jfkure/shot-timer-mk1/hardware/enclosure/Shot_Timer_Mk1_Enclosure_Drawings.pdf

# Shot Timer Mk1

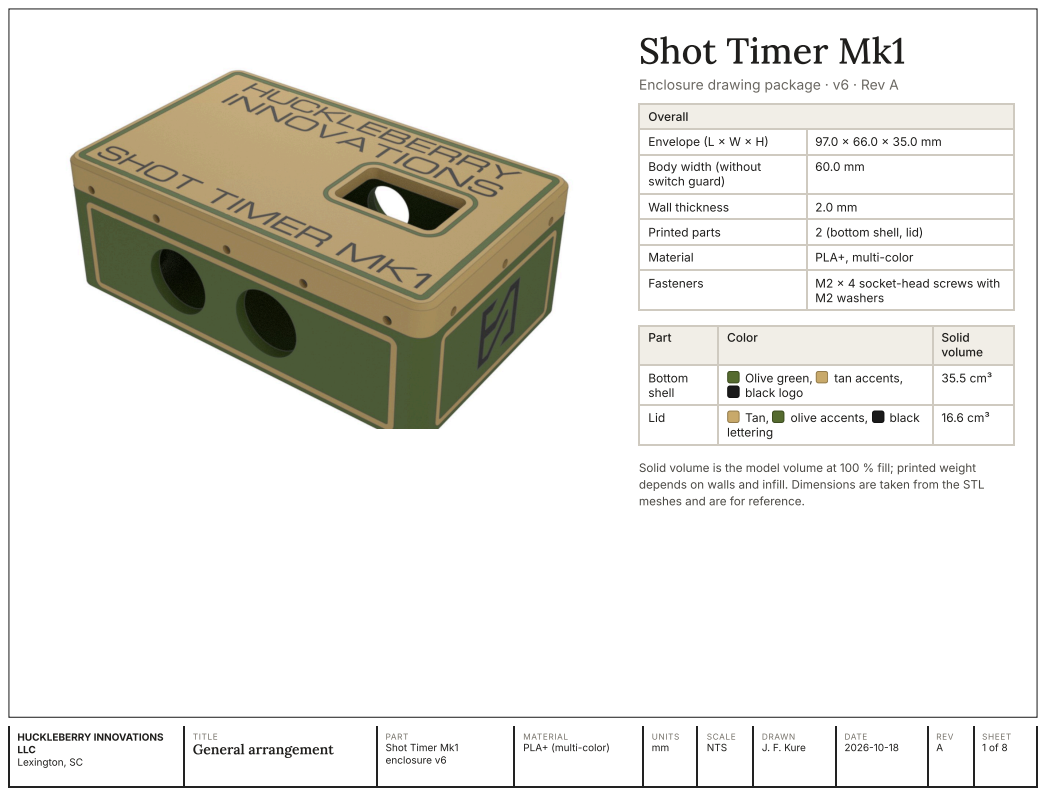
[picture p1: page 1]
Overall; HUCKLEBERRY INNOVATIONS LLC Lexington, SC; TITLE; General arrangement; PART Shot Timer Mk1 enclosure v6; UNITS mm; SCALE NTS; DRAWN J. F. Kure; DATE 2026-10-18; REV A; SHEET 1 of 8

Enclosure drawing package · v6 · Rev A

Envelope (L × W × H) | 97.0 × 66.0 × 35.0 mm
Body width (without switch guard) | 60.0 mm

Wall thickness | 2.0 mm
Printed parts | 2 (bottom shell, lid)
Material | PLA+, multi-color

Fasteners | M2 × 4 socket-head screws with M2 washers

Part | Color | Solid volume

Bottom shell | Olive green, tan accents, black logo | 35.5 cm³

Lid | Tan, olive accents, black lettering | 16.6 cm³

Solid volume is the model volume at 100 % fill; printed weight
depends on walls and infill. Dimensions are taken from the STL
meshes and are for reference.

MATERIAL
PLA+ (multi-color)

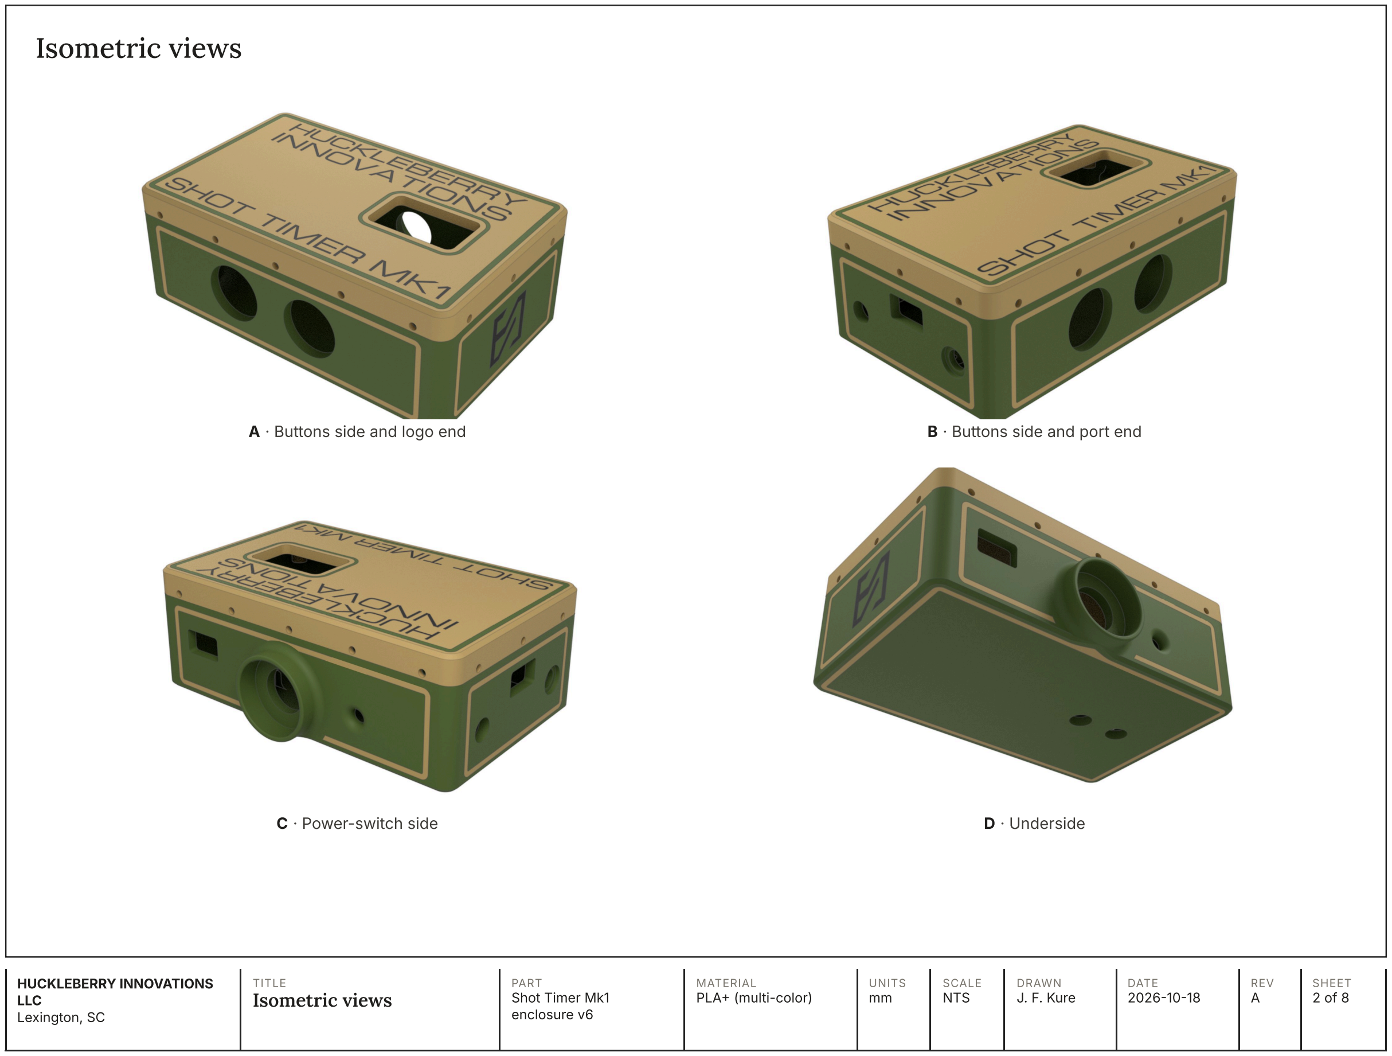
[picture p2: page 2]

### Isometric views

HUCKLEBERRY INNOVATIONS
LLC

TITLE
Isometric views

PART
Shot Timer Mk1

MATERIAL
PLA+ (multi-color)

UNITS
mm

SCALE
NTS

DRAWN
J. F. Kure

DATE
2026-10-18

REV
A

SHEET
2 of 8
A · Buttons side and logo end | B · Buttons side and port end
C · Power-switch side | D · Underside

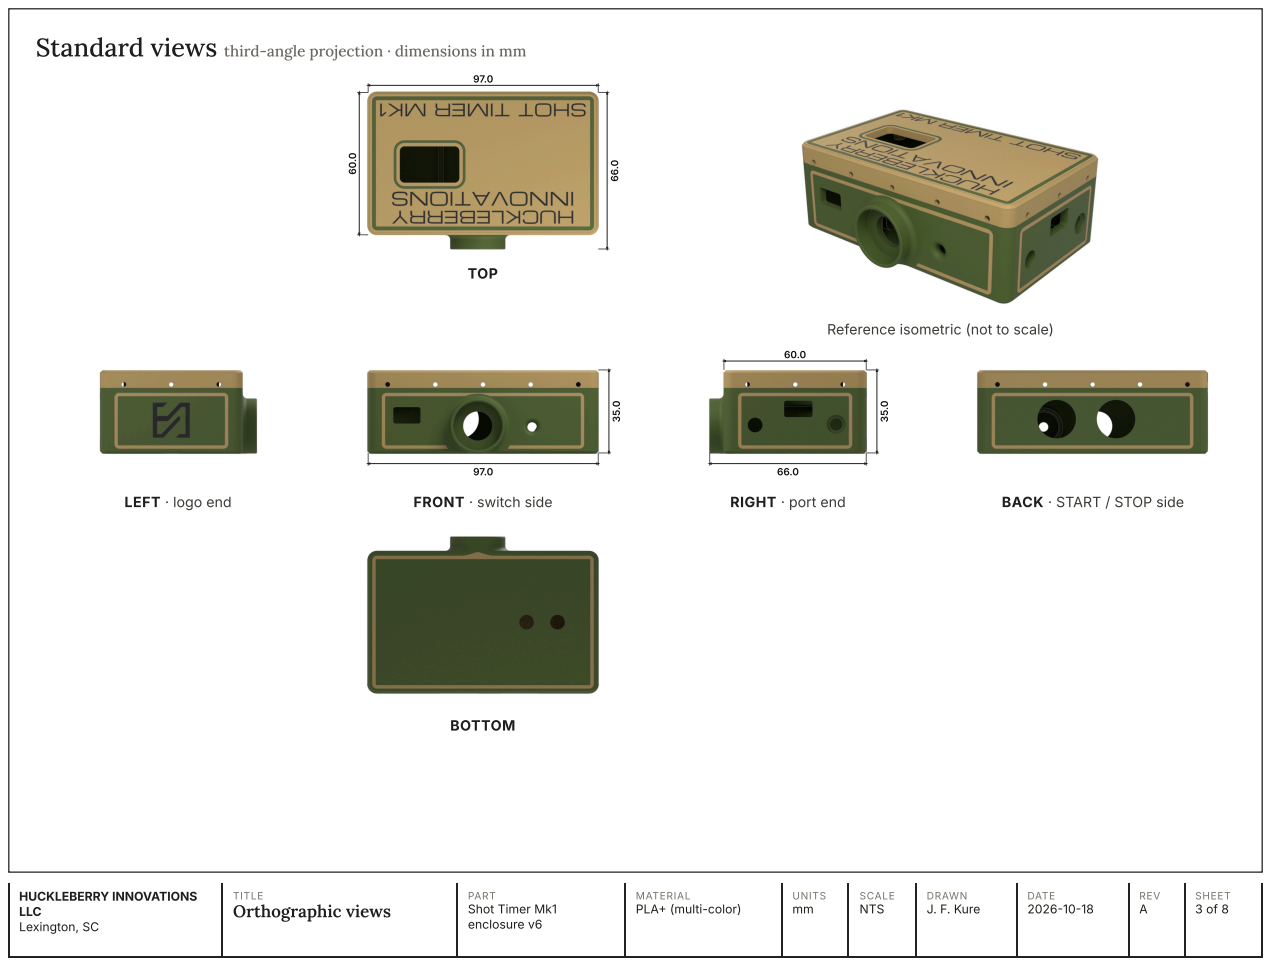
[picture p3: page 3]
HUCKLEBERRY INNOVATIONS LLC; TITLE Orthographic views; PART Shot Timer Mk1; UNITS mm; SCALE NTS; DRAWN J. F. Kure; DATE 2026-10-18; REV A; SHEET 3 of 8; TOP; LEFT · logo end; FRONT · switch side; RIGHT · port end; BACK · START / STOP side; BOTTOM

Standard views third-angle projection · dimensions in mm

Reference isometric (not to scale)

MATERIAL
PLA+ (multi-color)

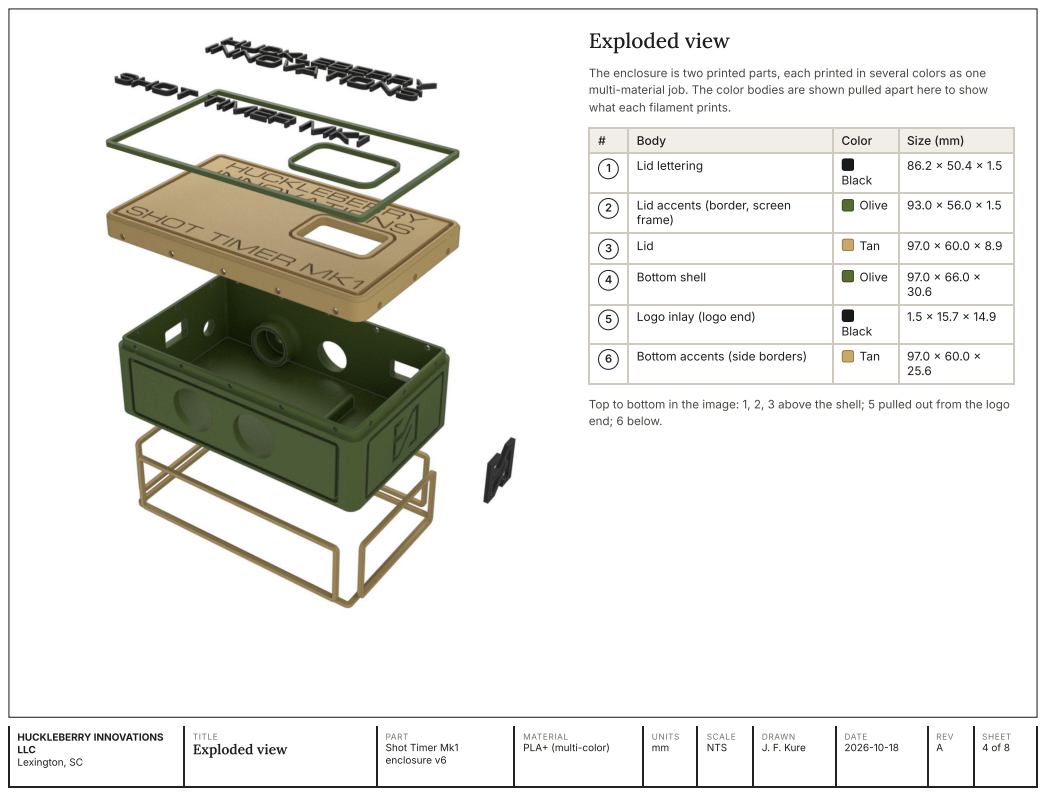
[picture p4: page 4]
Exploded view; HUCKLEBERRY INNOVATIONS LLC; TITLE Exploded view; PART Shot Timer Mk1; UNITS mm; SCALE NTS; DRAWN J. F. Kure; DATE 2026-10-18; REV A; SHEET 4 of 8

The enclosure is two printed parts, each printed in several colors as one
multi-material job. The color bodies are shown pulled apart here to show
what each filament prints.

# | Body | Color | Size (mm)
1 | Lid lettering | Black | 86.2 × 50.4 × 1.5

2 | Lid accents (border, screen frame) | Olive | 93.0 × 56.0 × 1.5

3 | Lid | Tan | 97.0 × 60.0 × 8.9

4 | Bottom shell | Olive | 97.0 × 66.0 × 30.6

5 | Logo inlay (logo end) | Black | 1.5 × 15.7 × 14.9

6 | Bottom accents (side borders) | Tan | 97.0 × 60.0 × 25.6

Top to bottom in the image: 1, 2, 3 above the shell; 5 pulled out from the logo
end; 6 below.

MATERIAL
PLA+ (multi-color)

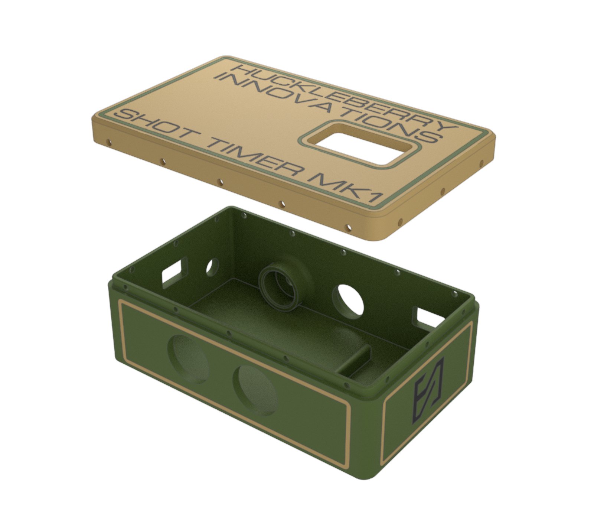
[picture p5: figure]

### Lid to shell

The lid sits on the shell with a lip that overlaps the shell walls by about 4.5 mm (lid underside at 26.1 mm, shell rim at 30.6 mm). It is held by M2 × 4 socket-head screws and M2 washers through the holes around the rim: five along each long side and three at each end, sixteen in all.

Item | Qty | Notes
Bottom shell | 1 | Electronics, buttons, switch and battery mount here
Lid | 1 | OLED shows through the screen window
M2 × 4 socket-head screw | 16 | Lid screws (rim holes)
M2 flat washer | 16 | Under each lid screw

HUCKLEBERRY INNOVATIONS LLC; TITLE Lid assembly; PART Shot Timer Mk1; MATERIAL PLA+ (multi-color); UNITS mm; SCALE NTS; DRAWN J. F. Kure; DATE 2026-10-18; REV A; SHEET 5 of 8

### Part · Bottom shell

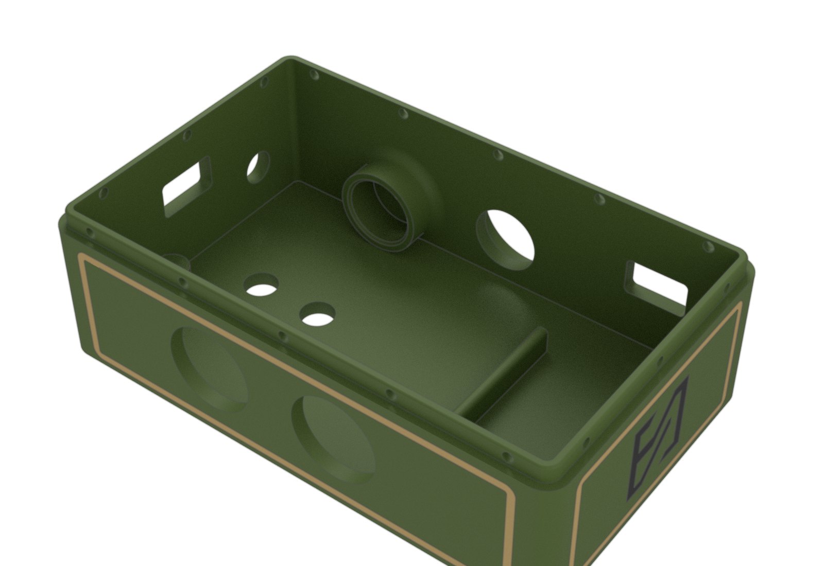
[picture p6: figure]
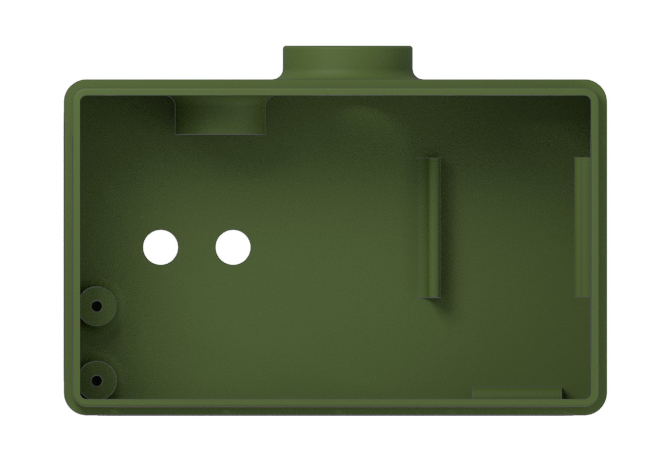
[picture p7: figure]

Feature | Size (mm) | Location
START / STOP button holes (2) | Ø 16.3 | Back wall, for 16 mm buttons
Power switch hole | Ø 12.3 | Front wall, inside the raised switch guard
Front wall openings | 7.0 × 11.5 slot; Ø 4.5 hole | Front wall, either side of the switch
Port-end openings | 7.0 × 12.0 slot; Ø 8.0 and Ø 6.3 holes | Right end wall
Floor holes (2) | Ø 6.4 | Floor
Inside cavity | 93.0 × 56.0, 2.0 walls | Shell height 30.6
Isometric | Top view into the cavity

HUCKLEBERRY INNOVATIONS LLC; TITLE; Bottom shell; PART Shot Timer Mk1; MATERIAL PLA+ (multi-color); UNITS mm; SCALE NTS; DRAWN J. F. Kure; DATE 2026-10-18; REV A; SHEET 6 of 8

Part · Lid

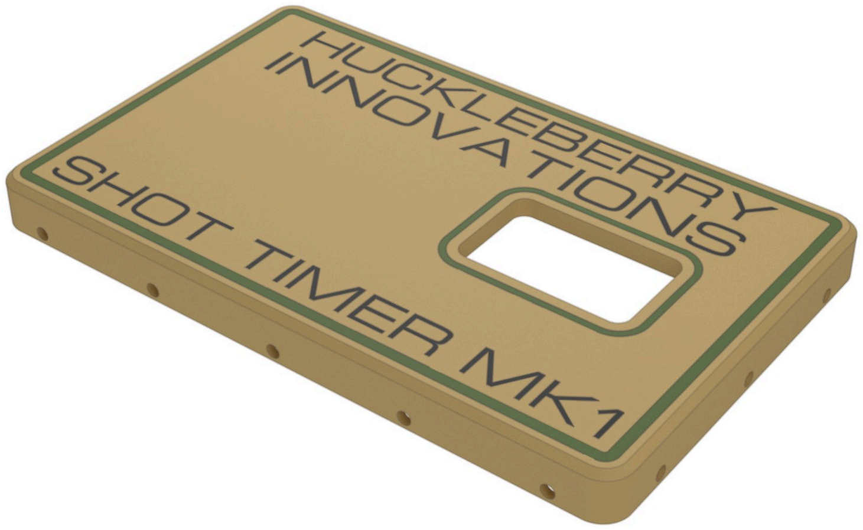
[picture p8: figure]
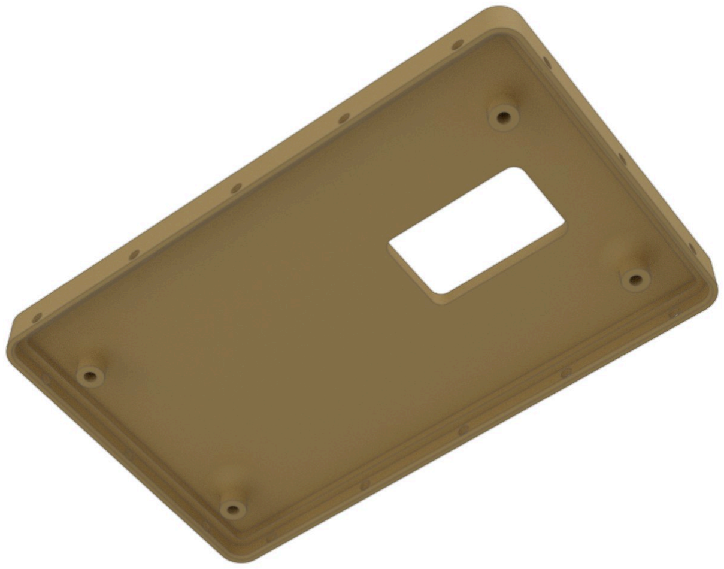
[picture p9: figure]

Feature | Size (mm) | Notes
Lid outline | 97.0 × 60.0 × 8.9 | Top face at 35.0 mm when assembled
Screen window | 25.0 × 15.2 opening, 30.0 × 20.2 frame | For the 0.96 in OLED
Lettering and border inlays | 1.5 deep | "HUCKLEBERRY INNOVATIONS", "SHOT TIMER MK1"
Isometric | Underside

HUCKLEBERRY INNOVATIONS LLC; TITLE Lid; PART Shot Timer Mk1; MATERIAL PLA+ (multi-color); UNITS mm; SCALE NTS; DRAWN J. F. Kure; DATE 2026-10-18; REV A; SHEET 7 of 8

### Color bodies

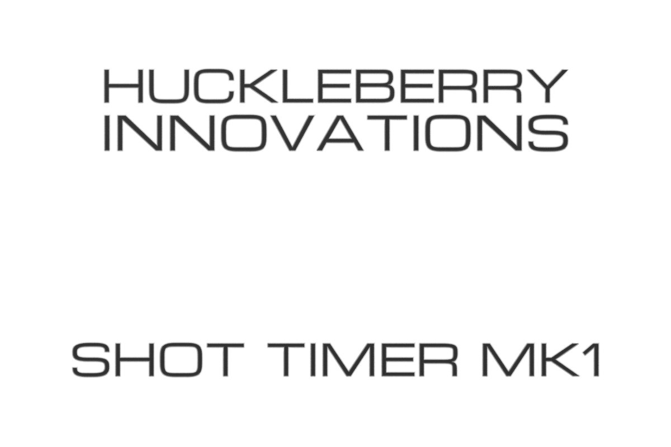
[picture p10: figure]

Files

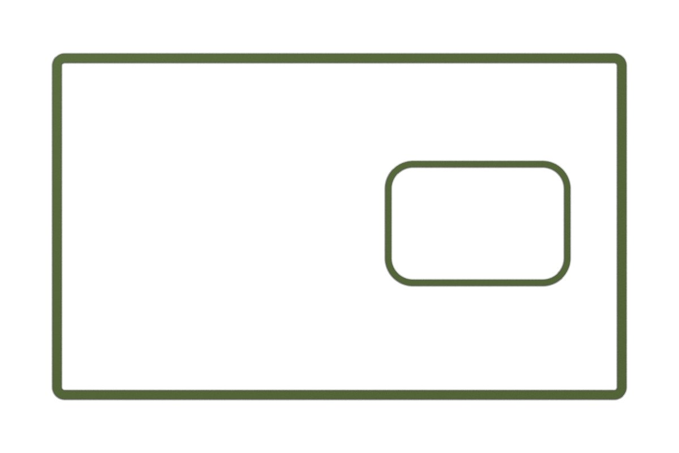
[picture p11: figure]
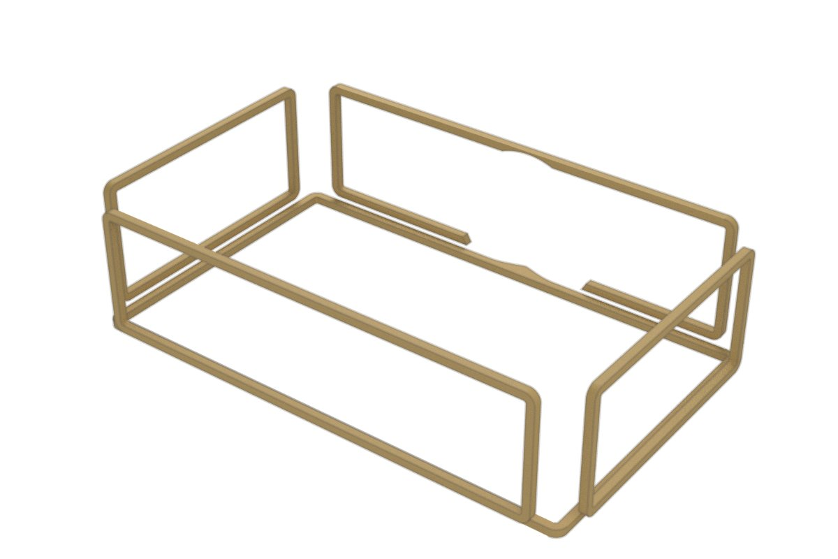
[picture p12: figure]
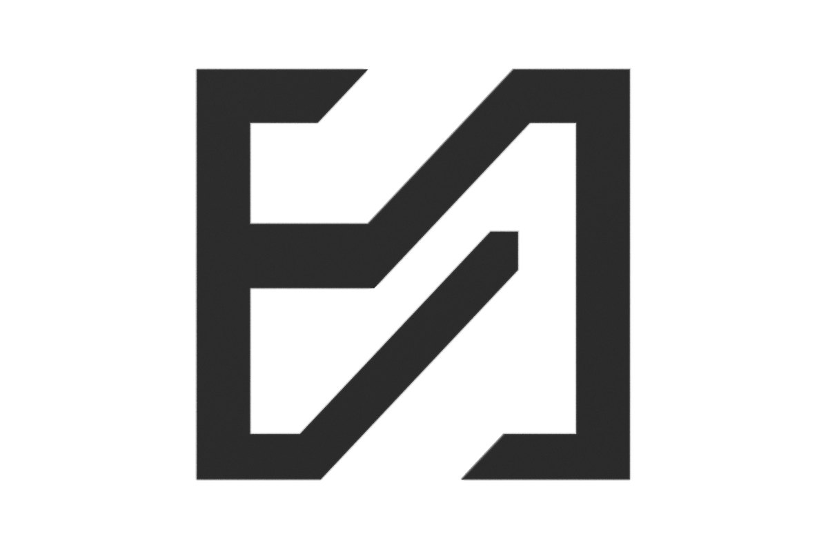
[picture p13: figure]

File | Body | Triangles
shot-timer-mk1 -shot timer enclosure v6 bottom olive green.stl | Bottom shell | 108,440
shot-timer-mk1 -Composite part bottom accents tan.stl | Shell accents | 6,192
shot-timer-mk1 -Composite part bottom logo black.stl | Logo | 88
shot-timer-mk1 -shot timer enclosure v6 top tan.stl | Lid | 77,008
shot-timer-mk1 -Composite part top accents olive green.stl | Lid accents | 2,376
shot-timer-mk1 -Composite part top names black.stl | Lid lettering | 15,436
shot-timer-mk1-bottom.3mf, shot-timer-mk1-top.3mf | Multi-color print projects with colors assigned | —

All STL files share one coordinate system, so loading them together in a slicer puts every color body in place. Print settings (layer height, infill, supports, orientation) are not recorded here yet.

Lid lettering · black | Lid accents · olive | Shell accents · tan

Logo · black

HUCKLEBERRY INNOVATIONS LLC; TITLE Color bodies and files; PART Shot Timer Mk1; MATERIAL PLA+ (multi-color); UNITS mm; SCALE NTS; DRAWN J. F. Kure; DATE 2026-10-18; REV A; SHEET 8 of 8
