jfkure/shot-timer-mk1/docs/Shot_Timer_MK1_Quick_Start_Fold_v1.7.5_BW.pdf

## SPECIFICATIONS

MCU | Arduino Nano
DISPLAY | 0.96" Dual-Color OLED
AUDIO | 3.5mm jack, clip-on lavalier
POWER | 9V USB-C Rechargeable Lithium
BATTERY GAUGE | % on every screen, ~16 hr runtime
POWER BTN | Latching, Blue-Lit, Guarded
MEMORY | 60 Shots / last string saved
RESOLUTION | 0.01 s display, 0.10 s min split
START DELAY | Random, 3–8 s
ENCLOSURE | PLA+ 3D Printed
FIRMWARE | Open Source v1.7.5
SOURCE | github.com/jfkure/shot-timer-mk1
LICENSE | GPL-3.0 · CERN-OHL-S · CC BY-SA
PRICE | $75.00 USD

### ORDER: order@huckleberryinnovations.com

HUCKLEBERRY INNOVATIONS — LEXINGTON, SC

# SHOT TIMER

MK1

HUCKLEBERRY INNOVATIONS
OPERATOR QUICK-START
HI

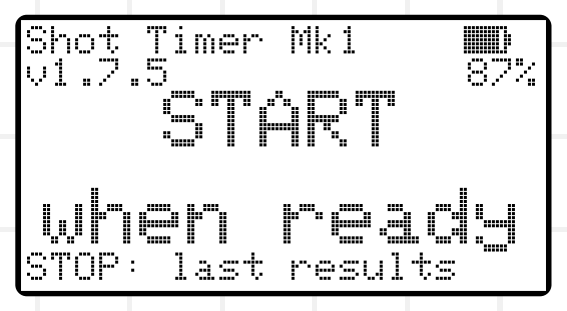
[picture p14: figure]

START SCREEN · v1.7.5

LEXINGTON, SC
J.F. KURE
v1.7.5

### 00 // POWER

A | POWER | Glows blue — timer ON, battery % top right
B | POWER | Depress — timer OFF, no battery drain

* Recessed guard prevents accidental presses

### 01 // RUN A STRING

1 | TAP START | LED on — random 3–8 s wait
2 | BUZZER · GO! | LED blinks — shoot, shots timed
3 | PRESS STOP | LED off — string saved, results up

Keep START a quick tap; holding 2 s opens test mode. Up to 60 shots. A pause over 65.5 s shows as 65.53+.

### 02 // REVIEW RESULTS

1ST SHOT › AVERAGE › SPLITS › TOTALS › BATTERY Tap STOP to step through pages; times in seconds. At power-on, tap STOP for your last string.

1ST SHOT · draw time | SPLITS · 3 per page

### 03 // BATTERY

Charge until the battery light turns green, then mark it full:
1 | TAP STOP | Go to the BATTERY page
2 | HOLD START 3s | MARK FULL? appears
3 | TAP STOP | FULL — gauge set to 100%
LOW | 15% left (~2 hr) — beep every 60 s
CHARGE | 5% left (~45 min) — double beep every 30 s

Rechargeable 9V lithium only. No beeps while shooting.

### 04 // SETUP

A | HOLD STOP 2s | Sensitivity: START +10, STOP saves
B | HOLD START 2s | Test mode: live mic level, STOP exits
C | HOLD BOTH 3s | Factory reset (threshold back to 150)

TIP Threshold 150 suits most ranges. Extra shots counted? Raise it. Shots missed? Lower it.

WHITE LED
- SOLID | Waiting for the beep · test & setup screens
~ BLINK | Clock running, listening for shots
- OFF | String stopped · reviewing results
START | STOP | POWER (lit when on)

huckleberryinnovations.com // github.com/jfkure/shot-timer-mk1 // LEXINGTON, SC

## SHOT TIMER MK1 — OPERATOR REFERENCE
