jfkure/shot-timer-mk1/docs/Shot_Timer_MK1_Parts_Inventory.pdf

Shot Timer MK1 Parts Inventory | Huckleberry Innovations LLC | BOM firmware v1.7.5, enclosure v6
Date: | Counted by: | Units to build:
Ref | Part | Per
timer

Pack
qty

On

hand | Need | Short | Order
(packs)

Ordered
/ date | Notes
U1 | Arduino Nano (ATmega328P) USB-C | 1 | 3
U2 | 0.96in SSD1306 OLED 128x64 I2C | 1 | 1
U3 | INA219 current sensor (0.1 ohm shunt) | 1 | 3
PCB1 | ElectroCookie solderable protoboard | 1 | 5
MK1 | Clip-on lavalier microphone 3.5mm TRRS | 1 | 1
J1 | TRRS 3.5mm breakout board | 1 | 6
BT1 | 9V USB-C rechargeable lithium battery | 1 | 5
BT1-CLIP | 9V battery clip with leads | 1 | 10
SW1 | Latching power switch blue-lit guarded | 1 | 6
SW2 | 16mm push button green (START) | 1 | 5
SW3 | 16mm push button red (STOP) | 1 | 5
LS1 | Buzzer | 1 | 5
D1 | White LED panel-mount | 1 | 5
CONN | 2-pin wire connector/plug | 3 | 30
R1 | 10k 1% resistor | 1 | 25
R2a/R5 | 2.2k 1% resistor | 2 | 25
R2b | 4.7k 1% resistor | 1 | 25
R3 | 100k 1% resistor | 1 | 25
R4a | 22k 1% resistor | 1 | 25
R4b | 68k 1% resistor | 1 | 25
C1 | 10uF electrolytic capacitor | 1 | 10
ENC | 3D-printed PLA+ enclosure (top + bottom) | 1 | 1
HW1 | M2x4 socket head screw | 22 | 100
HW2 | M2 flat washer | 22 | 500
CLIP | Belt clip | 1 | 2

Hookup wire

Solder

Heat shrink

PLA+ filament

Notes / reorder list | Need = Per timer x units to build. Short = Need - On hand.
Rows from hardware/BOM.csv (github.com/jfkure/shot-timer-mk1). Hardware CERN-OHL-S-2.0, docs CC BY-SA 4.0. | CONN comes in pairs. Battery: 9V USB-C rechargeable lithium only.
