jfkure/shot-timer-mk1/hardware/enclosure/port-plug-measured.stl

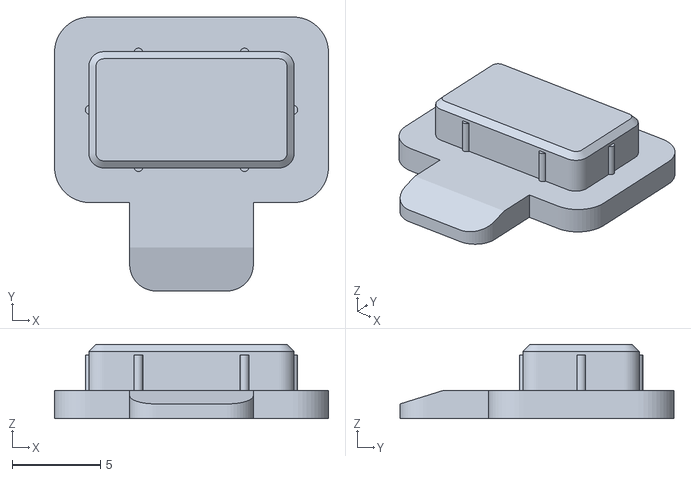
[picture p15: CAD file, 2026-10-19]
hardware/enclosure/port-plug-measured.stl
15.5 x 15.5 x 4.20
