jfkure/shot-timer-mk1/hardware/enclosure/shot-timer-mk1 - Composite part top accents olive green.stl

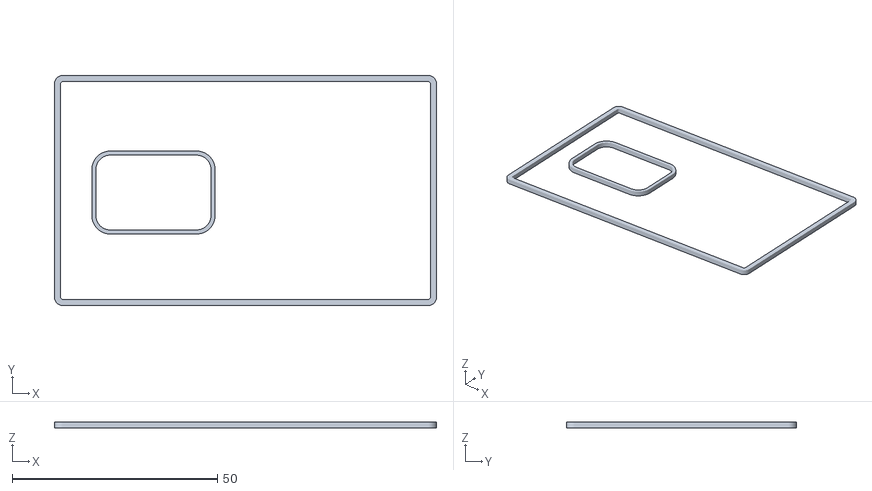
[picture p16: CAD file, 2026-10-19]
hardware/enclosure/shot-timer-mk1 - Composite part top accents olive green.stl
93.0 x 56.0 x 1.50
