jfkure/shot-timer-mk1/hardware/enclosure/shot-timer-mk1-bottom.3mf

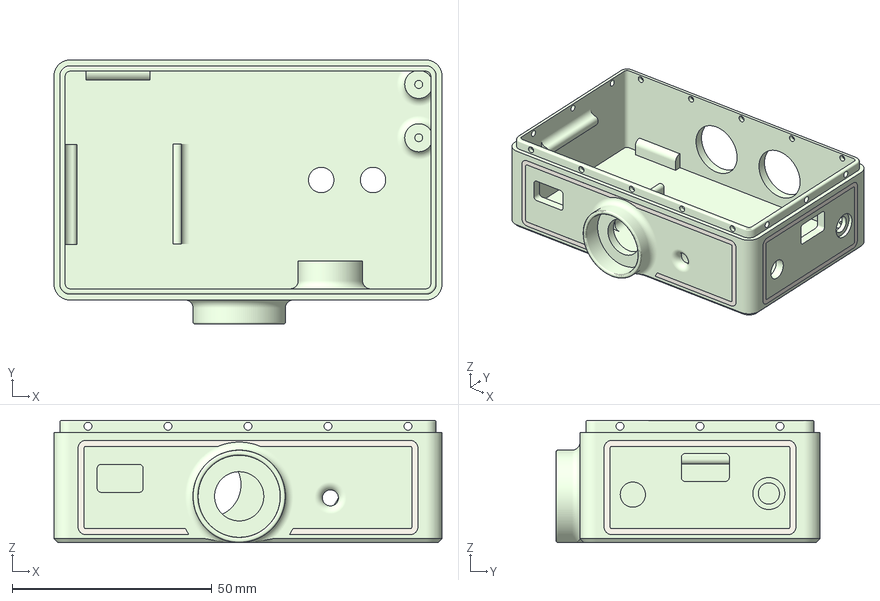
[picture p17: CAD file, 2026-10-19]
hardware/enclosure/shot-timer-mk1-bottom.3mf
97.0 x 66.0 x 30.6 mm
shot timer enclosure v6 bottom olive green
bottom-start-stop-buttons-accent
bottom-logo-border-accent
bottom-enclosure-accent
bottom-headphone-jack-accent
bottom-logo-accent
bottom-power-switch-accent
