jfkure/shot-timer-mk1/hardware/enclosure/shot-timer-mk1 - shot timer enclosure v6 bottom olive green.stl

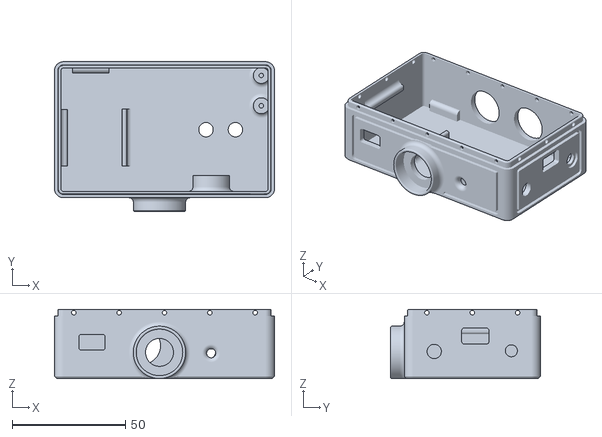
[picture p18: CAD file, 2026-10-19]
hardware/enclosure/shot-timer-mk1 - shot timer enclosure v6 bottom olive green.stl
97.0 x 66.0 x 30.6
