jfkure/shot-timer-mk1/hardware/enclosure/shot-timer-mk1-top.3mf

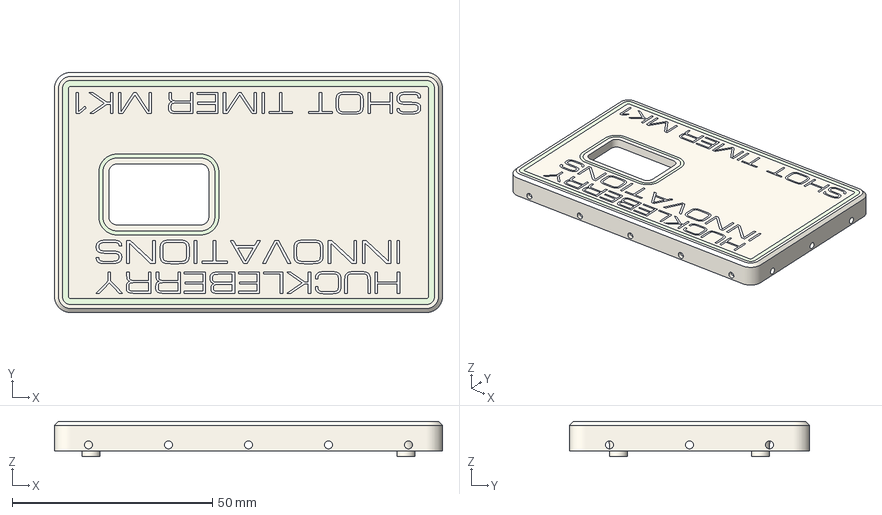
[picture p19: CAD file, 2026-10-19]
hardware/enclosure/shot-timer-mk1-top.3mf
97.0 x 60.0 x 8.87 mm
top-enclosure-accent
top-screen-accent
shot timer enclosure v6 top tan
