jfkure/shot-timer-mk1/hardware/enclosure/shot-timer-mk1 - Composite part top names black.stl

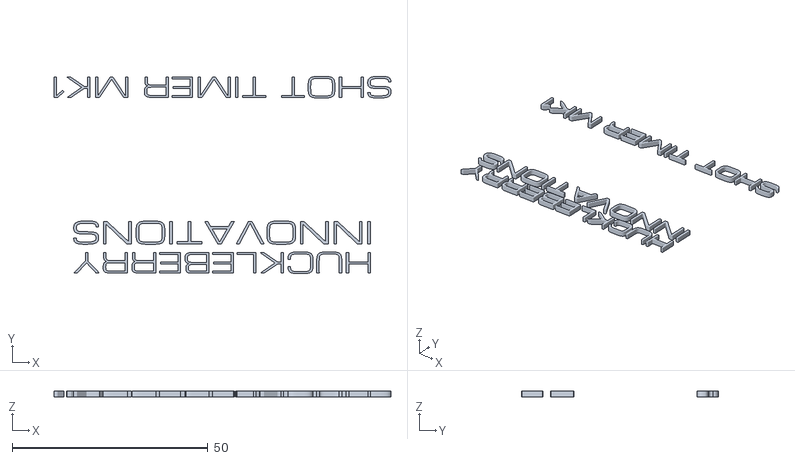
[picture p20: CAD file, 2026-10-19]
hardware/enclosure/shot-timer-mk1 - Composite part top names black.stl
86.2 x 50.4 x 1.50
