jfkure/shot-timer-mk1/hardware/enclosure/shot-timer-mk1 - Composite part bottom accents tan.stl

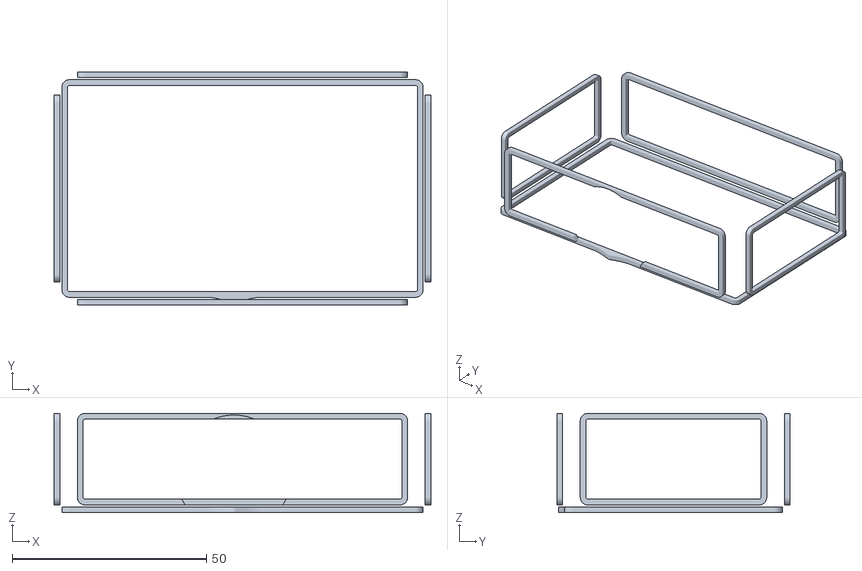
[picture p21: CAD file, 2026-10-19]
hardware/enclosure/shot-timer-mk1 - Composite part bottom accents tan.stl
97.0 x 60.0 x 25.6
