jfkure/shot-timer-mk1/hardware/enclosure/shot-timer-mk1 - Composite part bottom logo black.stl

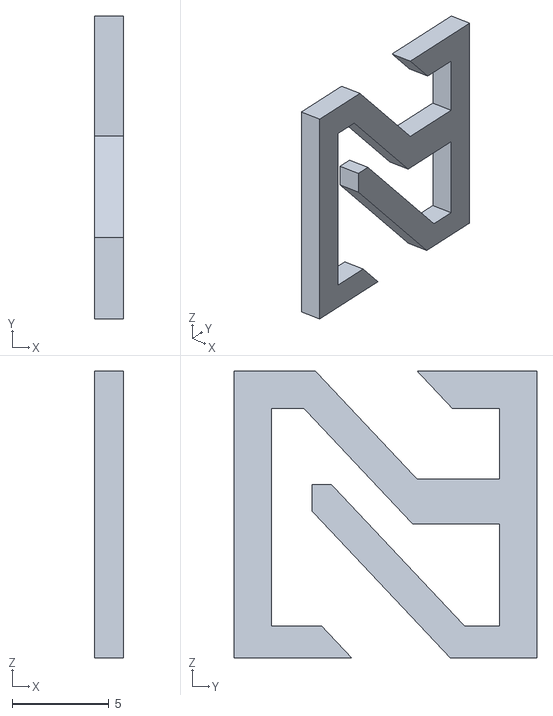
[picture p22: CAD file, 2026-10-19]
hardware/enclosure/shot-timer-mk1 - Composite part bottom logo black.stl
1.50 x 15.7 x 14.9
