jfkure/shot-timer-mk1/hardware/enclosure/shot-timer-mk1 - shot timer enclosure v6 top tan.stl

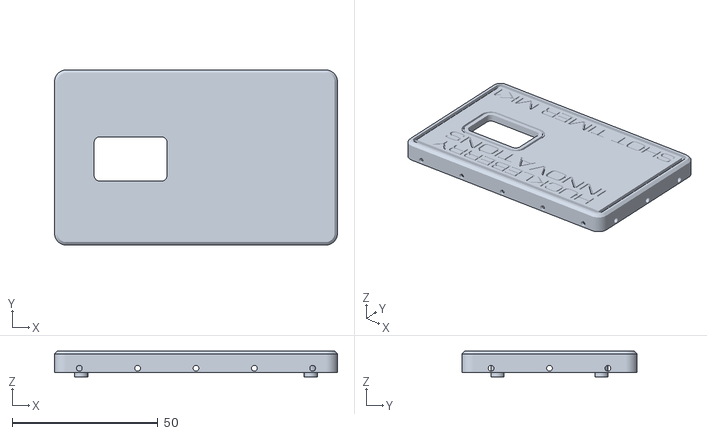
[picture p23: CAD file, 2026-10-19]
hardware/enclosure/shot-timer-mk1 - shot timer enclosure v6 top tan.stl
97.0 x 60.0 x 8.87
