jfkure/shot-timer-mk1/hardware/schematic/shot-timer-mk1.kicad_sch

## KiCad design hardware/schematic/shot-timer-mk1.kicad_sch (2026-10-19)

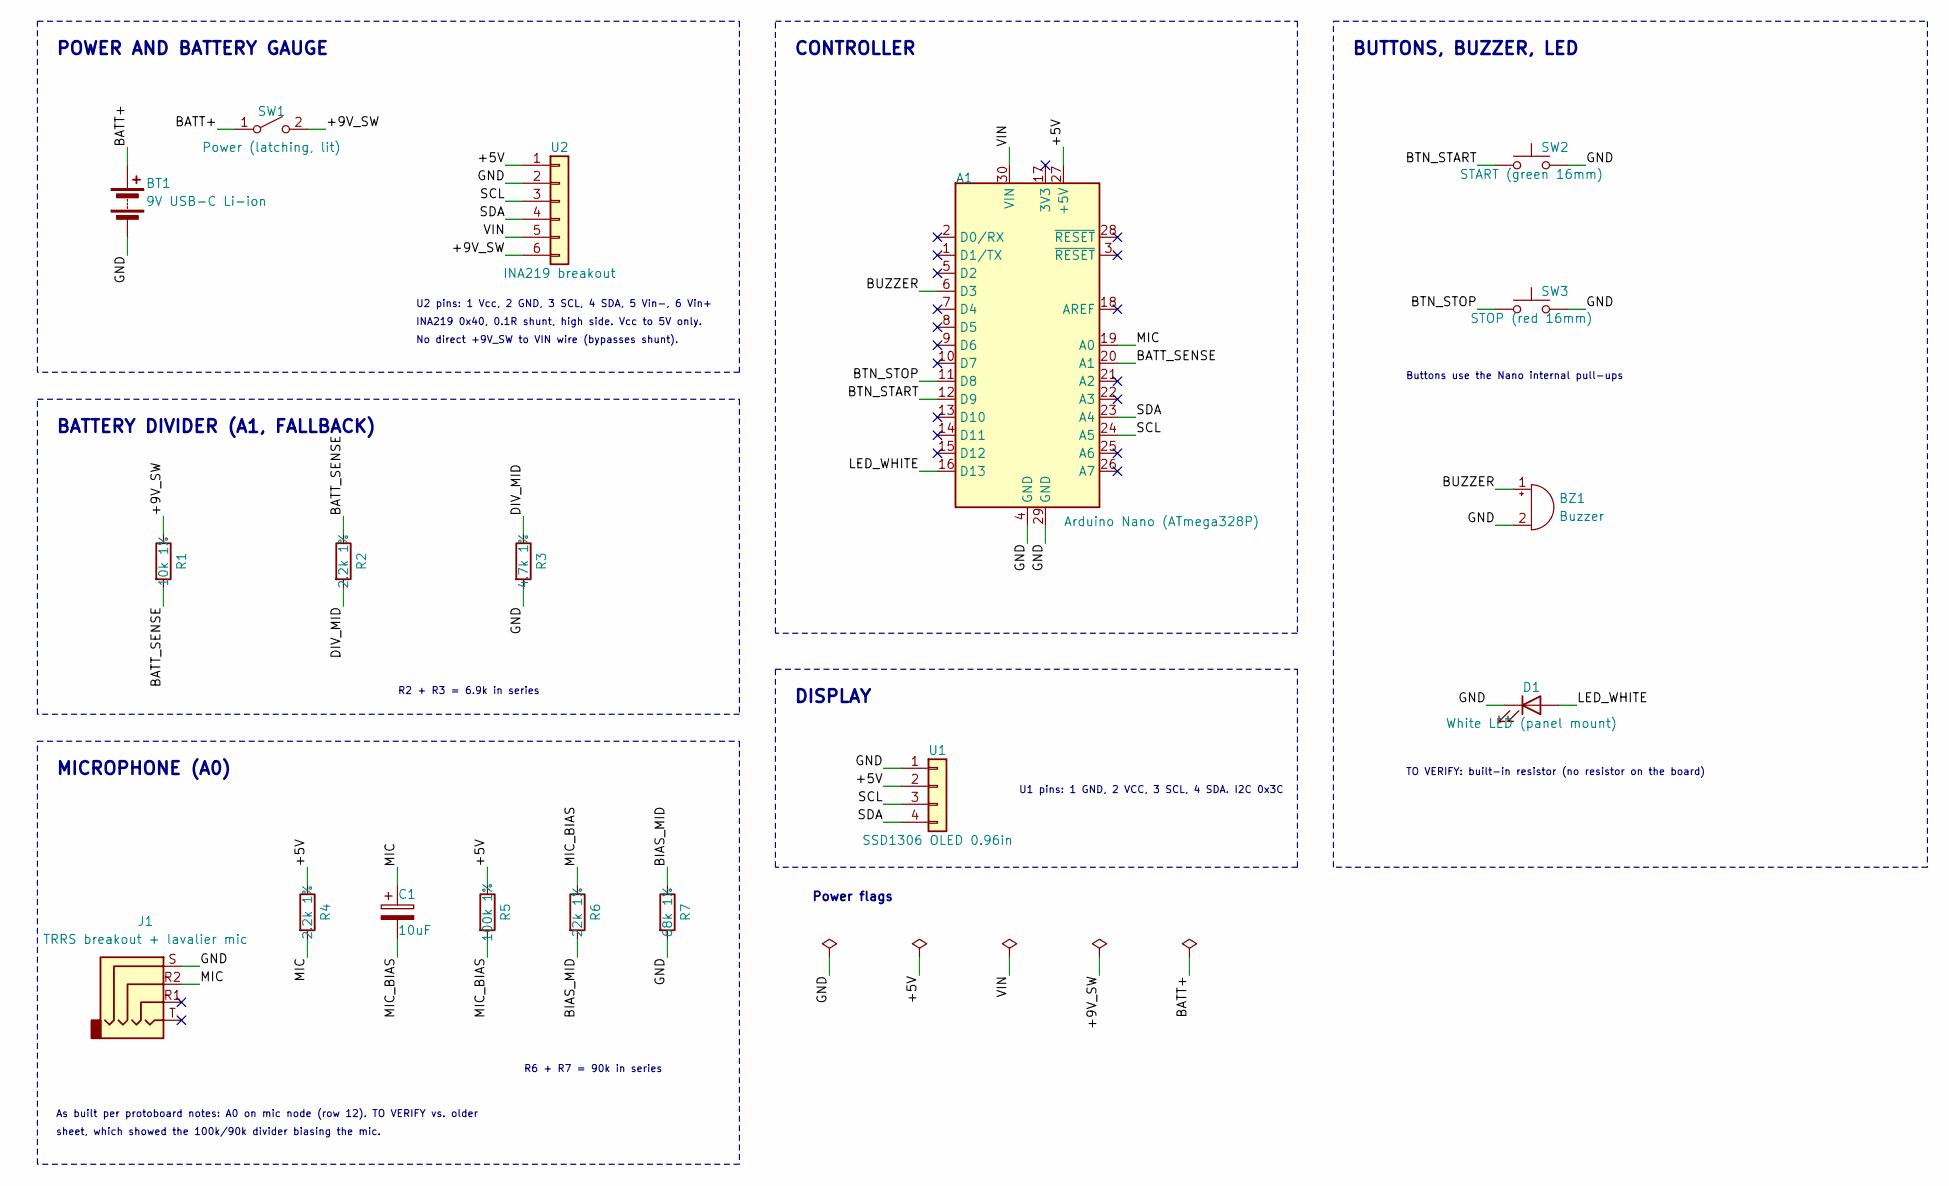
[picture p32: schematic shot-timer-mk1.kicad_sch]

Parts:
A1: Arduino Nano (ATmega328P); Arduino_Nano
BT1: 9V USB-C Li-ion
BZ1: Buzzer
C1: 10uF
D1: White LED (panel mount)
J1: TRRS breakout + lavalier mic
R1: 10k 1%
R2, R4: 2.2k 1%
R3: 4.7k 1%
R5: 100k 1%
R6: 22k 1%
R7: 68k 1%
SW1: Power (latching, lit)
SW2: START (green 16mm)
SW3: STOP (red 16mm)
U1: SSD1306 OLED 0.96in
U2: INA219 breakout

Connections:
+5V: A1.27 (+5V), R4.1, R5.1, U1.2, U2.1
+9V_SW: R1.1, SW1.2 (B), U2.6
BATT+: BT1.1 (+), SW1.1 (A)
BATT_SENSE: A1.20 (A1), R1.2, R2.1
BIAS_MID: R6.2, R7.1
BTN_START: A1.12 (D9), SW2.1
BTN_STOP: A1.11 (D8), SW3.1
BUZZER: A1.6 (D3), BZ1.1 (+)
DIV_MID: R2.2, R3.1
GND: A1.4 (GND), A1.29 (GND), BT1.2 (-), BZ1.2 (-), D1.1 (K), J1.S, R3.2, R7.2, SW2.2, SW3.2, U1.1, U2.2
LED_WHITE: A1.16 (D13), D1.2 (A)
MIC: A1.19 (A0), C1.1, J1.R2, R4.2
MIC_BIAS: C1.2, R5.2, R6.1
SCL: A1.24 (A5), U1.3, U2.3
SDA: A1.23 (A4), U1.4, U2.4
VIN: A1.30 (VIN), U2.5

Notes on the sheet:
CONTROLLER
POWER AND BATTERY GAUGE
U2 pins: 1 Vcc, 2 GND, 3 SCL, 4 SDA, 5 Vin-, 6 Vin+
INA219 0x40, 0.1R shunt, high side. Vcc to 5V only.
No direct +9V_SW to VIN wire (bypasses shunt).
BATTERY DIVIDER (A1, FALLBACK)
R2 + R3 = 6.9k in series
MICROPHONE (A0)
R6 + R7 = 90k in series
As built per protoboard notes: A0 on mic node (row 12). TO VERIFY vs. older
sheet, which showed the 100k/90k divider biasing the mic.
DISPLAY
U1 pins: 1 GND, 2 VCC, 3 SCL, 4 SDA. I2C 0x3C
BUTTONS, BUZZER, LED
Buttons use the Nano internal pull-ups
TO VERIFY: built-in resistor (no resistor on the board)
Power flags
