jfkure/shot-timer-mk1/(commit log)

2026-10-18 Shot Timer MK1 v1.7.5 – firmware, manuals, licenses
2026-10-19 Add hardware documentation, KiCad schematic and enclosure files
    - hardware/BOM.csv and WIRING.md
    - hardware/schematic: KiCad project and PDF export
    - hardware/enclosure: STL/3MF print files and drawing package
    - docs: Hardware Build Guide
    - README: new repository layout and "Building one" section
    [BOM.csv, shot-timer-mk1 - Composite part bottom accents tan.stl, shot-timer-mk1 - Composite part bottom logo black.stl, shot-timer-mk1 - Composite part top accents olive green.stl, shot-timer-mk1 - Composite part top names black.stl, shot-timer-mk1 - shot timer enclosure v6 bottom olive green.stl, shot-timer-mk1 - shot timer enclosure v6 top tan.stl, shot-timer-mk1-bottom.3mf]
2026-10-19 Project Book
    Putting all the Shot Timer Mk1 project information into one comprehensive document
2026-10-19 Usb-c comms port plug
    -cover the comms programming port side of enclosure to protect from debris or water
    [port-plug-measured.stl]
2026-10-20 BOM updates
2026-10-20 parts inventory fillable sheet
    -Helps anyone building their own timer
