jfkure/shot-timer-mk1/(notices)

Notices in the files:
firmware/ShotTimerMk1_v1_7_5/ShotTimerMk1_v1_7_5.ino:
under the terms of the GNU General Public License as published by the Free
details: https://www.gnu.org/licenses/gpl-3.0.html
hardware/schematic/shot-timer-mk1.kicad_sch:
github.com/jfkure/shot-timer-mk1 - CERN-OHL-S-2.0
